MelindaBirkenstock/USB-C-Treadstone-32/Treadstone32.kicad_pcb

## KiCad design Treadstone32.kicad_pcb (2021-04-15)

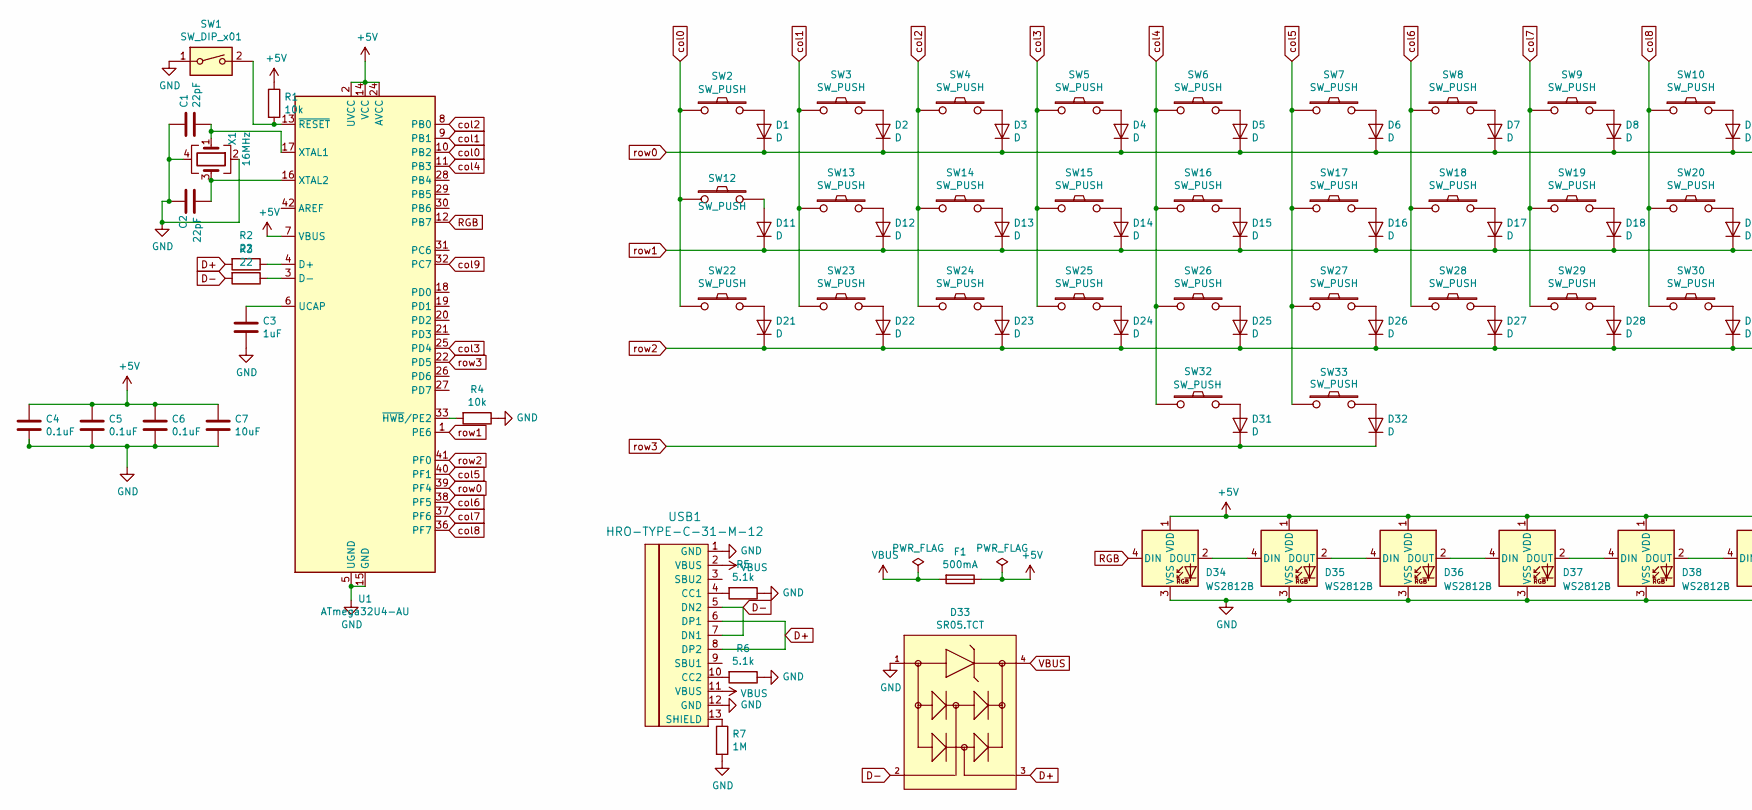
[picture p1: schematic Treadstone32.sch, part in row 1, column 1]

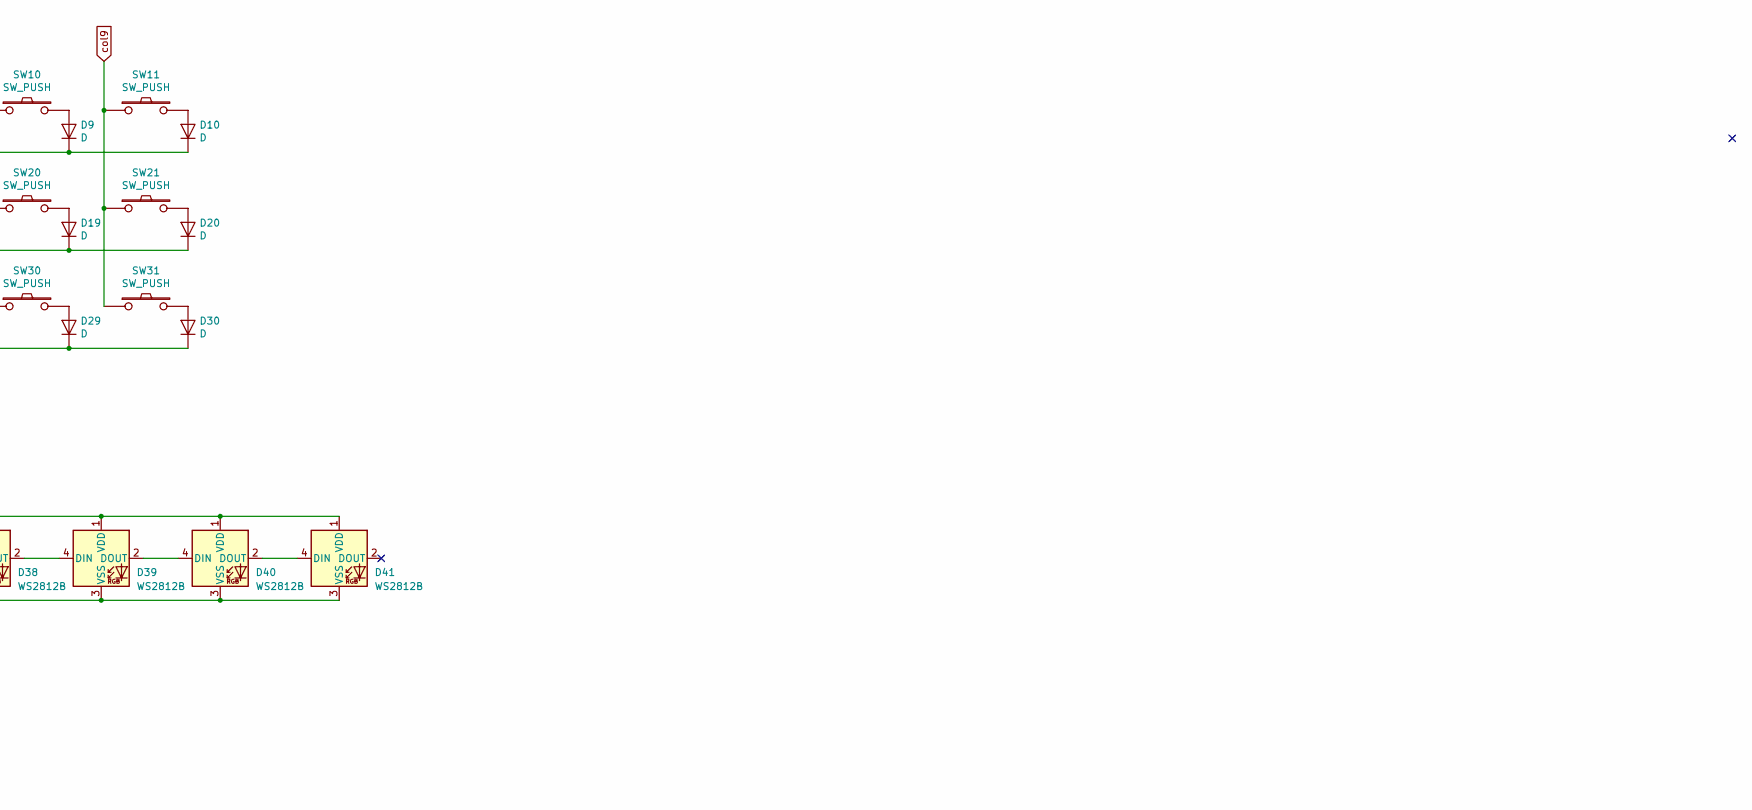
[picture p2: schematic Treadstone32.sch, part in row 1, column 2]

Parts:
C1, C2: 22pF; C_0805_2012Metric
C3: 1uF; C_0805_2012Metric
C4, C5, C6: 0.1uF; C_0805_2012Metric
C7: 10uF; C_0805_2012Metric
D1, D2, D3, D4, D5, D6, D7, D8, D9, D10, D11, D12, D13, D14, D15, D16, D17, D18, D19, D20, D21, D22, D23, D24, D25, D26, D27, D28, D29, D30, D31, D32: D; D_SOD-123
D33: SR05.TCT; Semtech-SOT-143-0-0-MFG; breakdown voltage 6V; clamping voltage 20V; mouser part number 947-SR05.TCT; digikey description TVS DIODE 5V 20V SOT143-4
D34, D35, D36, D37, D38, D39, D40, D41: WS2812B; LED_WS2812B_PLCC4_5.0x5.0mm_P3.2mm
F1: 500mA; Fuse_0805_2012Metric
R1, R4: 10k; R_0805_2012Metric
R2, R3: 22; R_0805_2012Metric
R5, R6: 5.1k; R_0805_2012Metric
R7: 1M; R_0805_2012Metric
SW1: SW_DIP_x01; PinHeader_1x02_P2.00mm_Vertical
SW2, SW3, SW4, SW5, SW6, SW7, SW8, SW9, SW10, SW11, SW12, SW13, SW14, SW15, SW16, SW17, SW18, SW19, SW20, SW21, SW22, SW23, SW24, SW25, SW26, SW27, SW28, SW29, SW30, SW31, SW32, SW33: SW_PUSH; MXOnly-1U-NoLED
U1: ATmega32U4-AU; TQFP-44_10x10mm_P0.8mm
USB1: HRO-TYPE-C-31-M-12; HRO-TYPE-C-31-M-12-HandSoldering
X1: 16MHz; Crystal_SMD_3225-4Pin_3.2x2.5mm_HandSoldering

Connections:
+5V: C4.1, C5.1, C6.1, C7.1, D34.1 (VDD), D35.1 (VDD), D36.1 (VDD), D37.1 (VDD), D38.1 (VDD), D39.1 (VDD), D40.1 (VDD), D41.1 (VDD), F1.1, R1.1, U1.2 (UVCC), U1.7 (VBUS), U1.14 (VCC), U1.24 (AVCC), U1.34 (VCC), U1.44 (AVCC)
D+: D33.3 (2_I/O), R2.2, USB1.6 (DP1), USB1.8 (DP2)
D-: D33.2 (1_I/O), R3.2, USB1.5 (DN2), USB1.7 (DN1)
GND: C1.1, C2.1, C3.2, C4.2, C5.2, C6.2, C7.2, D33.1 (ANODE), D34.3 (VSS), D35.3 (VSS), D36.3 (VSS), D37.3 (VSS), D38.3 (VSS), D39.3 (VSS), D40.3 (VSS), D41.3 (VSS), R4.1, R5.1, R6.1, R7.2, SW1.1, U1.5 (UGND), U1.15 (GND), U1.23 (GND), U1.35 (GND), U1.43 (GND), USB1.1 (GND), USB1.12 (GND), X1.2, X1.4
unnamed: C1.2, U1.17 (XTAL1), X1.1
unnamed: C2.2, U1.16 (XTAL2), X1.3
unnamed: C3.1, U1.6 (UCAP)
unnamed: D1.2 (A), SW2.2
unnamed: D2.2 (A), SW3.2
unnamed: D3.2 (A), SW4.2
unnamed: D4.2 (A), SW5.2
unnamed: D5.2 (A), SW6.2
unnamed: D6.2 (A), SW7.2
unnamed: D7.2 (A), SW8.2
unnamed: D8.2 (A), SW9.2
unnamed: D9.2 (A), SW10.2
unnamed: D10.2 (A), SW11.2
unnamed: D11.2 (A), SW12.2
unnamed: D12.2 (A), SW13.2
unnamed: D13.2 (A), SW14.2
unnamed: D14.2 (A), SW15.2
unnamed: D15.2 (A), SW16.2
unnamed: D16.2 (A), SW17.2
unnamed: D17.2 (A), SW18.2
unnamed: D18.2 (A), SW19.2
unnamed: D19.2 (A), SW20.2
unnamed: D20.2 (A), SW21.2
unnamed: D21.2 (A), SW22.2
unnamed: D22.2 (A), SW23.2
unnamed: D23.2 (A), SW24.2
unnamed: D24.2 (A), SW25.2
unnamed: D25.2 (A), SW26.2
unnamed: D26.2 (A), SW27.2
unnamed: D27.2 (A), SW28.2
unnamed: D28.2 (A), SW29.2
unnamed: D29.2 (A), SW30.2
unnamed: D30.2 (A), SW31.2
unnamed: D31.2 (A), SW32.2
unnamed: D32.2 (A), SW33.2
unnamed: D34.2 (DOUT), D35.4 (DIN)
unnamed: D35.2 (DOUT), D36.4 (DIN)
unnamed: D36.2 (DOUT), D37.4 (DIN)
unnamed: D37.2 (DOUT), D38.4 (DIN)
unnamed: D38.2 (DOUT), D39.4 (DIN)
unnamed: D39.2 (DOUT), D40.4 (DIN)
unnamed: D40.2 (DOUT), D41.4 (DIN)
unnamed: R1.2, SW1.2, U1.13 (~RESET)
unnamed: R2.1, U1.4 (D+)
unnamed: R3.1, U1.3 (D-)
unnamed: R4.2, U1.33 (~HWB~/PE2)
unnamed: R5.2, USB1.4 (CC1)
unnamed: R6.2, USB1.10 (CC2)
unnamed: R7.1, USB1.13 (SHIELD)
RGB: D34.4 (DIN), U1.12 (PB7)
VBUS: D33.4 (CATHODE), F1.2, USB1.2 (VBUS), USB1.11 (VBUS)
col0: SW2.1, SW12.1, SW22.1, U1.10 (PB2)
col1: SW3.1, SW13.1, SW23.1, U1.9 (PB1)
col2: SW4.1, SW14.1, SW24.1, U1.8 (PB0)
col3: SW5.1, SW15.1, SW25.1, U1.25 (PD4)
col4: SW6.1, SW16.1, SW26.1, SW32.1, U1.11 (PB3)
col5: SW7.1, SW17.1, SW27.1, SW33.1, U1.40 (PF1)
col6: SW8.1, SW18.1, SW28.1, U1.38 (PF5)
col7: SW9.1, SW19.1, SW29.1, U1.37 (PF6)
col8: SW10.1, SW20.1, SW30.1, U1.36 (PF7)
col9: SW11.1, SW21.1, SW31.1, U1.32 (PC7)
row0: D1.1 (K), D2.1 (K), D3.1 (K), D4.1 (K), D5.1 (K), D6.1 (K), D7.1 (K), D8.1 (K), D9.1 (K), D10.1 (K), U1.39 (PF4)
row1: D11.1 (K), D12.1 (K), D13.1 (K), D14.1 (K), D15.1 (K), D16.1 (K), D17.1 (K), D18.1 (K), D19.1 (K), D20.1 (K), U1.1 (PE6)
row2: D21.1 (K), D22.1 (K), D23.1 (K), D24.1 (K), D25.1 (K), D26.1 (K), D27.1 (K), D28.1 (K), D29.1 (K), D30.1 (K), U1.41 (PF0)
row3: D31.1 (K), D32.1 (K), U1.22 (PD5)

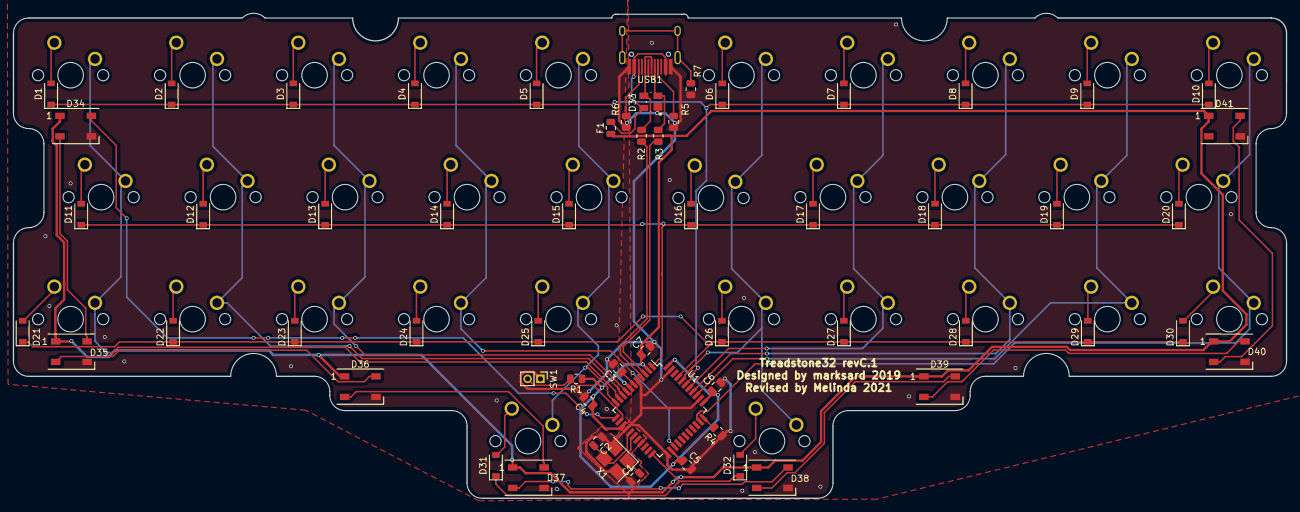
[picture p3: board Treadstone32.kicad_pcb from above]

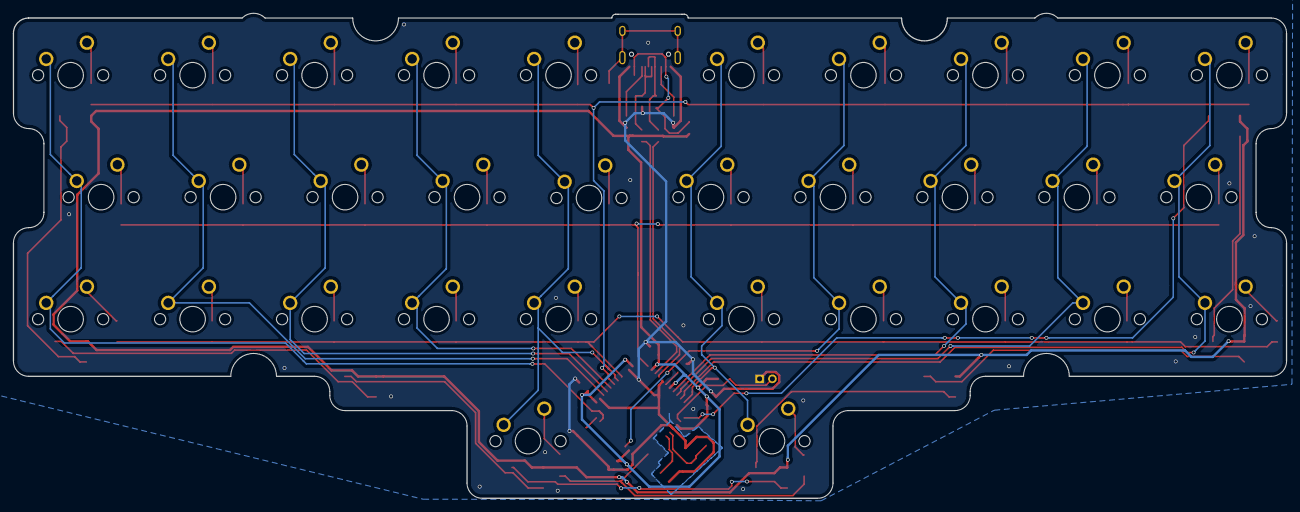
[picture p4: board Treadstone32.kicad_pcb from below]

Board: 2 copper layers, 198.8 x 75.8 mm, 92 parts (32 on the bottom side), 69 nets.
