MelindaBirkenstock/USB-C-Treadstone-32/(commit log)

2021-01-28 First push
    Initial push of my variant of the treadstone32 that has usb-c and some modifications.
    [Treadstone32.kicad_pcb, Treadstone32.sch, Treadstone32_case.kicad_pcb, Treadstone32_plate.kicad_pcb, Treadstone32_plate.sch]
2021-02-22 Pcb edits
    [Treadstone32.kicad_pcb, Treadstone32.sch]
2021-03-13 Add underglow and switch to solderable switches
    [Treadstone32.kicad_pcb, Treadstone32.sch]
2021-03-13 Cleanup refs
    [Treadstone32.kicad_pcb]
